willhunt/silvia/docs/docs/README.md

---
home: true
heroImage: /assets/will_silvia_icon.png
tagline: Silviabot smart espresso machine.
actionText: Demo →
actionLink: /demo/
features:
- title: Temperature control
  details: Precise boiler temperature stabilisation using PID control
- title: Remote operation
  details: Machine control via web app, hosted onboard. Turn machine on, create a schedule and view previous sessions.
- title: Brew control
  details: Brew to specified mass, measured using a separate WiFi scale.
footer: Made by William Hunt with VuePress
---
