willhunt/silvia/docs/docs/demo/README.md

# Introduction
## Direct Operation
This video shows demonstration of the machine being used without the web app. Brewing is automatically stopped at the target mass although some additional coffee comes through after the stop is requested (room for improvement). As can be seen the machine is poorly dialled in....just testing at the moment.

<iframe width="560" height="315" src="https://www.youtube.com/embed/h3jJNOzg5Io" frameborder="0" allow="accelerometer; autoplay; clipboard-write; encrypted-media; gyroscope; picture-in-picture" allowfullscreen></iframe>
