willhunt/silvia/docs/docs/control/assets/boiler_boundary_diagram.png

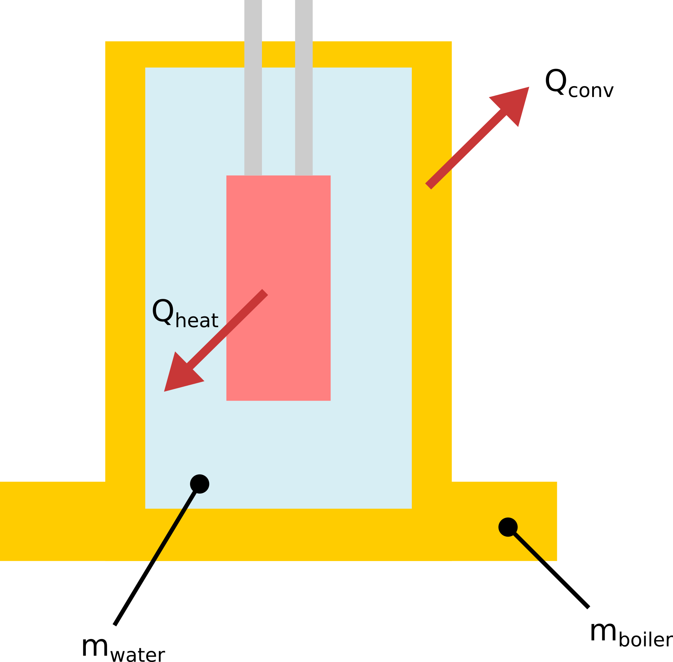
docs/docs/control/assets/boiler_boundary_diagram.png
