willhunt/silvia/docs/docs/.vuepress/public/assets/build/oled_display_panel_facia.stl

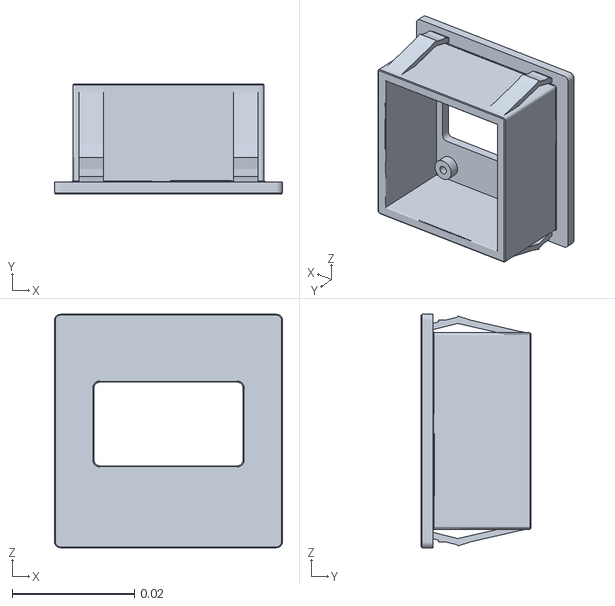
[picture p6: CAD file, 2020-06-29]
docs/docs/.vuepress/public/assets/build/oled_display_panel_facia.stl
0.0373 x 0.018 x 0.0382
