willhunt/silvia/docs/docs/build/power-control.md

---
images_installation: [
    {src: "build_powerrelay_01.jpg", caption: "Installed relay"},
]
images_wiring: [
    {src: "wiring_powercontrol_01.png", caption: "Fritzing wiring diagram for power control"},
]
---

# Power Control
Digital power control was implemented by rewiring the power switch connections to a relay. The switch can be used indirectly to power the machine by wiring to a digital microcontroller pin. The main power switch is a double pole, single throw (DPST) switch, connecting both the live and neutral circuits. To replace this a dual relay was used. The relay used requires 12V to switch so a mosfet is needed to switch from the microcontroller output (5V with Arduino) to a higher 12V circuit. It would have been better to use a relay with a 5V coil voltage but this is what I had available.

## Components
* T92P7D22-12 DPST-NO Relay [[datasheet](https://www.te.com/commerce/DocumentDelivery/DDEController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)]
    * 277V, 30A
    * Dual relay
    * 12V coil voltage
* [12VDC power supply](./power-supply.md)
* IRF520 Mosfet [[datasheet](https://www.vishay.com/docs/91017/91017.pdf)]
    * Gate threshold voltage 4V
    * Drain-source voltage 100V

## Installation

<DocsImageLayout :images="$frontmatter.images_installation" srcBase="/silvia/assets/build/"></DocsImageLayout>

## Wiring
The Arduino switches the mechanical relay with 12V (supplied through barrel jack) with an IRF520 mosfet. A 1k&#8486; pull-down resistor is used to ensure the mosfet input is at 0V when the output in not high. The raspberry pi detects the switch operation via a GPIO pin. This does not require a pull up/down resistor as they are built in.

<DocsImageLayout :images="$frontmatter.images_wiring" size="lg" srcBase="/silvia/assets/build/"></DocsImageLayout>

## Software
### Raspberry pi interrupt
The raspberry pi gpiozero [Button class](https://gpiozero.readthedocs.io/en/stable/api_input.html#gpiozero.Button) is used to detect switch operation which then communicates to the Arduino over I2C via [Celery](https://github.com/celery/celery) asyncrhonus tasks.

```python
from gpiozero import Button

button_power = Button(17)
button_power.when_pressed = trigger_machine_on
button_power.when_released = trigger_machine_off
```

The python interrupt file is registered as a django management command:
```bash
$ python manage.py raspi_interrupt
```

### Arduino relay control
A generic relay control class was used to operate the relays through the standard Arduino interface with the relevant `on()` method being:
```cpp
void RelayOutput::on() {
  status_ = true;
  digitalWrite(pin_, HIGH);
};

```
