willhunt/silvia/docs/docs/setup/arduino-setup.md

# Arduino Setup

The following Arduino libraries are required:

* Wire
* PID
* ~~PID_AutoTune_v0~~
* Adafruit SSD1306
* Adafruit GFX

The arduino can be flashed from the raspberry pi using the script:
```bash
$ cd ~/silvia
$ ./update_arduino.sh
```
