willhunt/silvia/(list of files, drawings)

Other design files:
docs/docs/build/assets/silvia.fzz
docs/docs/build/assets/silvia_brew_control.fzz
docs/docs/build/assets/silvia_oled_display.fzz
docs/docs/build/assets/silvia_power_control.fzz
docs/docs/build/assets/silvia_power_control_old.fzz
docs/docs/build/assets/silvia_scale.fzz
docs/docs/build/assets/silvia_temperature_control.fzz
