willhunt/silvia/silvia_scale/silvia_scale_wifi.h

#ifndef SILVIA_SCALE_WIFI_H
#define SILVIA_SCALE_WIFI_H

#include <ESP8266WiFi.h>
#include <WiFiClient.h>
#include <ESP8266WebServer.h>
#include <ESP8266HTTPClient.h>
#include "wifi_details.h"  // Wifi SSID & password
#include "silvia_scale_display.h"
#include "silvia_scale_timer.h"
#include "silvia_scale_loadcell.h"


ESP8266WebServer* scaleWifiSetup(IPAddress ip, IPAddress subnet, IPAddress gateway, IPAddress dns);
void handleRoot();
void handleGetMass();
void handleTare();
void handleBrewStart();
void handleBrewStop();
void sendBrewStop();

extern double setpoint;
extern double mass;
extern unsigned long t;

#endif  // SILVIA_SCALE_WIFI_H
