willhunt/silvia/silvia/silviacontrol/signals.py

from django.db.models.signals import pre_save, post_delete, post_save
from django.dispatch import receiver
from django.conf import settings as django_settings
from .models import ScheduleModel, ResponseModel, StatusModel, SettingsModel, SessionModel
from .tasks import async_comms_update, async_scale_update
from django_celery_beat.models import CrontabSchedule, PeriodicTask, IntervalSchedule

@receiver(pre_save, sender=ScheduleModel)
def save_schedule(sender, instance, raw, using, update_fields, **kwargs):
    """
    When creating schedule model also create linked django_celery_beat schedule entries
    """
    dow_crontype = ScheduleModel.convert_dow_to_crontype(instance.days)
    # ON SCHEDULE
    if instance.schedule_on is None:
        crontab_on = CrontabSchedule.objects.create(
            minute=instance.t_on.minute,
            hour=instance.t_on.hour,
            day_of_week=dow_crontype,
            day_of_month='*',
            month_of_year='*',
            timezone=django_settings.TIME_ZONE
        )
        schedule_on = PeriodicTask.objects.create(
            crontab=crontab_on,
            name="on:{0} {1}".format(instance.id, instance.name),
            # task='silviacontrol.tasks.async_machine_on',
            task='silviacontrol.tasks.async_comms_update',
            args='[true]',  # json format required
            enabled=instance.active
        )
        instance.schedule_on = schedule_on
    else:
        instance.schedule_on.name = "on:{0} {1}".format(instance.id, instance.name)
        instance.schedule_on.crontab.minute = instance.t_on.minute
        instance.schedule_on.crontab.hour = instance.t_on.hour
        instance.schedule_on.crontab.day_of_week = dow_crontype
        instance.schedule_on.crontab.save()
        instance.schedule_on.enabled = instance.active
        instance.schedule_on.save()
    # OFF SCHEDULE
    if instance.schedule_off is None:
        crontab_off = CrontabSchedule.objects.create(
            minute=instance.t_off.minute,
            hour=instance.t_off.hour,
            day_of_week=dow_crontype,
            day_of_month='*',
            month_of_year='*',
            timezone=django_settings.TIME_ZONE
        )
        schedule_off = PeriodicTask.objects.create(
            crontab=crontab_off,
            name="off:{0} {1}".format(instance.id, instance.name),
            # task='silviacontrol.tasks.async_machine_off',
            task='silviacontrol.tasks.async_comms_update',
            args='[false]',  # json format required
            enabled=instance.active
        )
        instance.schedule_off = schedule_off
    else:
        instance.schedule_off.name = "off:{0} {1}".format(instance.id, instance.name)
        instance.schedule_off.crontab.minute = instance.t_off.minute
        instance.schedule_off.crontab.hour = instance.t_off.hour
        instance.schedule_off.crontab.day_of_week = dow_crontype
        instance.schedule_off.crontab.save()
        instance.schedule_off.enabled = instance.active
        instance.schedule_off.save()


@receiver(post_delete, sender=ScheduleModel)
def delete_schedule(sender, instance, **kwargs):
    """
    When deleting schedule model also delete linked django_celery_beat schedule entries
    """
    try:
        instance.schedule_on.delete()
    except (AssertionError, AttributeError) as e:
        print('No on schedule')
    try:
        instance.schedule_off.delete()
    except (AssertionError, AttributeError) as e:
        print('No off schedule')
    try:
        instance.schedule_on.crontab.delete()
    except (AssertionError, AttributeError) as e:
        print('No Crontab on')
    try:
        instance.schedule_off.crontab.delete()
    except (AssertionError, AttributeError) as e:
        print('No Crontab off')

# @receiver(pre_save, sender=ResponseModel)
# def pre_save_response(sender, instance, raw, using, update_fields, **kwargs):
#     """
#     When creating response model check brewing status and add
#     """
#     status = StatusModel.objects.get(id=1)
#     # Set brewing in response - Now doing this in async_save_response()
#     instance.brewing = status.brew

    # Check if brewing and mass target is reached
    # if status.brew:
    #    settings = SettingsModel.objects.get(id=1)
    #     if instance.m is not None and instance.m >= settings.m:
    #         status.brew = False
    #         status.save()

@receiver(post_save, sender=SettingsModel)
def save_settings(sender, instance, raw, using, update_fields, **kwargs):
    """
    When updating settings model update periodic task and arduino settings
    """
    status = StatusModel.objects.get(pk=1)
    # See if periodic temperature update task exists
    try:
        periodic_response = PeriodicTask.objects.get(name="Get Response")
        #  Update period if different
        if periodic_response.interval.every != instance.t_sample:
            periodic_response.interval.every = instance.t_sample
            periodic_response.interval.save()
    except PeriodicTask.DoesNotExist:
        # Create periodic task if it doesn't exist
        periodic_interval = IntervalSchedule.objects.create(
            every=instance.t_sample,
            period='seconds'
        )
        periodic_response = PeriodicTask.objects.create(
            name="Get Response",
            task="silviacontrol.tasks.async_comms_response",
            enabled=status.on,
            interval=periodic_interval
        )
    # Send to Arduino (update settings, not status, current status values given)
    async_comms_update.delay(status.on, status.brew, status.mode)

@receiver(pre_save, sender=StatusModel)
def save_status(sender, instance, raw, using, update_fields, **kwargs):
    """
    When saving status model turn temperature update on/off
    When saving status model create or end schedule as necessary
    """
    # Account for first creation
    try:
        prior_status = StatusModel.objects.get(pk=1)
    except StatusModel.DoesNotExist as e:
        print("No pre-save processing as no status model found, please create one")
        return False

    # Fill in values not sent
    if not hasattr(instance, "on"):
        instance.on = prior_status.on
    if not hasattr(instance, "brew"):
        instance.brew = prior_status.brew
    if not hasattr(instance, "mode"):
        instance.mode = prior_status.mode

    # Turn on/off periodic response
    try:
        periodic_response = PeriodicTask.objects.get(name="Get Response")
        periodic_response.enabled = instance.on
        periodic_response.save()
    except:
        raise ValueError("Save sample time to create 'Get Response' periodic task")

    # Start/stop sessions
    if instance.on and not prior_status.on:  # Turning machine on
        # Create a new session
        session = SessionModel()
        session.save()
        # If simulating, set temperature to 20degC
        if django_settings.SIMULATE_MACHINE:
            response = ResponseModel.objects.create(
                T_boiler=20,
                duty=0,
                duty_p=0,
                duty_i=0,
                duty_d=0,
                m=0
            )
            response.save()
    elif prior_status.on and not instance.on:  # If machine is being turned off
        # Get current session
        try:
            session = SessionModel.objects.filter(active=True).order_by('-id')[0]
            session.set_end_time()
            session.save()
        except IndexError as e:
            print("No active session")
