willhunt/silvia/silvia_scale/check_circle_outline.h

#define CHECK_CIRCLE_OUTLINE_WIDTH 24
#define CHECK_CIRCLE_OUTLINE_HEIGHT 24
const uint8_t check_circle_outline[] PROGMEM = {
  0x00, 0x00, 0x00, 0x00, 0x00, 0x00, 0x00, 0x7E, 0x00, 0x80, 0xFF, 0x01, 
  0xE0, 0xC1, 0x07, 0x60, 0x00, 0x07, 0x30, 0x00, 0x0C, 0x38, 0x00, 0x1C, 
  0x18, 0x00, 0x3B, 0x0C, 0x80, 0x31, 0x0C, 0xC0, 0x31, 0x0C, 0xF0, 0x30, 
  0xCC, 0x39, 0x30, 0x8C, 0x39, 0x30, 0x1C, 0x1F, 0x38, 0x18, 0x07, 0x18, 
  0x38, 0x02, 0x18, 0x30, 0x00, 0x0C, 0xE0, 0x00, 0x0F, 0xE0, 0x83, 0x07, 
  0x80, 0xFF, 0x01, 0x00, 0x7E, 0x00, 0x00, 0x00, 0x00, 0x00, 0x00, 0x00, 
  };
