willhunt/silvia/silvia_scale/checkbox-marked-circle.h

#define CHECKED_CIRCLE_WIDTH 48
#define CHECKED_CIRCLE_HEIGHT 48
const uint8_t checked_circle[] PROGMEM = {
  0xFF, 0xFF, 0xFF, 0xFF, 0xFF, 0xFF, 0xFF, 0xFF, 0xFF, 0xFF, 0xFF, 0xFF, 
  0xFF, 0xFF, 0xFF, 0xFF, 0xFF, 0xFF, 0xFF, 0xFF, 0xFF, 0xFF, 0xFF, 0xFF, 
  0xFF, 0xFF, 0x01, 0x80, 0xFF, 0xFF, 0xFF, 0x7F, 0x00, 0x00, 0xFE, 0xFF, 
  0xFF, 0x1F, 0x00, 0x00, 0xF8, 0xFF, 0xFF, 0x0F, 0x00, 0x00, 0xF0, 0xFF, 
  0xFF, 0x03, 0x00, 0x00, 0xC0, 0xFF, 0xFF, 0x01, 0x00, 0x00, 0x80, 0xFF, 
  0xFF, 0x00, 0x00, 0x00, 0x00, 0xFF, 0xFF, 0x00, 0x00, 0x00, 0x00, 0xFF, 
  0x7F, 0x00, 0x00, 0x00, 0x00, 0xFE, 0x3F, 0x00, 0x00, 0x00, 0x00, 0xFC, 
  0x3F, 0x00, 0x00, 0x00, 0x08, 0xFC, 0x1F, 0x00, 0x00, 0x00, 0x1C, 0xF8, 
  0x1F, 0x00, 0x00, 0x00, 0x1E, 0xF8, 0x0F, 0x00, 0x00, 0x00, 0x0F, 0xF0, 
  0x0F, 0x00, 0x00, 0x80, 0x07, 0xF0, 0x0F, 0x00, 0x00, 0xC0, 0x03, 0xF0, 
  0x0F, 0x00, 0x00, 0xE0, 0x01, 0xF0, 0x0F, 0x00, 0x00, 0xF0, 0x00, 0xF0, 
  0x0F, 0x10, 0x00, 0x78, 0x00, 0xF0, 0x0F, 0x38, 0x00, 0x3C, 0x00, 0xF0, 
  0x0F, 0x78, 0x00, 0x1E, 0x00, 0xF0, 0x0F, 0xF0, 0x00, 0x0F, 0x00, 0xF0, 
  0x0F, 0xE0, 0x81, 0x07, 0x00, 0xF0, 0x0F, 0xC0, 0xC3, 0x03, 0x00, 0xF0, 
  0x0F, 0x80, 0xE7, 0x01, 0x00, 0xF0, 0x0F, 0x00, 0xFF, 0x00, 0x00, 0xF0, 
  0x0F, 0x00, 0x7E, 0x00, 0x00, 0xF0, 0x1F, 0x00, 0x3C, 0x00, 0x00, 0xF8, 
  0x1F, 0x00, 0x18, 0x00, 0x00, 0xF8, 0x3F, 0x00, 0x00, 0x00, 0x00, 0xFC, 
  0x3F, 0x00, 0x00, 0x00, 0x00, 0xFC, 0x7F, 0x00, 0x00, 0x00, 0x00, 0xFE, 
  0xFF, 0x00, 0x00, 0x00, 0x00, 0xFF, 0xFF, 0x00, 0x00, 0x00, 0x00, 0xFF, 
  0xFF, 0x01, 0x00, 0x00, 0x80, 0xFF, 0xFF, 0x03, 0x00, 0x00, 0xC0, 0xFF, 
  0xFF, 0x0F, 0x00, 0x00, 0xF0, 0xFF, 0xFF, 0x1F, 0x00, 0x00, 0xF8, 0xFF, 
  0xFF, 0x7F, 0x00, 0x00, 0xFE, 0xFF, 0xFF, 0xFF, 0x01, 0x80, 0xFF, 0xFF, 
  0xFF, 0xFF, 0xFF, 0xFF, 0xFF, 0xFF, 0xFF, 0xFF, 0xFF, 0xFF, 0xFF, 0xFF, 
  0xFF, 0xFF, 0xFF, 0xFF, 0xFF, 0xFF, 0xFF, 0xFF, 0xFF, 0xFF, 0xFF, 0xFF, 
  };
