willhunt/silvia/(commit log)

2020-05-20 Basic frontend framework in place
2020-05-22 Changed on/off to switch
2020-05-22 Added temperature update
2020-05-26 Prototype ready for testing on hardware
2020-05-31 Format temperature
2020-05-31 Simulated aysnc temperature update
2020-06-03 Basic arduino sketch roughed out
2020-06-04 I2C test
2020-06-06 Script to detect button press
2020-06-06 Added GPIO for raspberry pi
2020-06-06 Pin number fix
2020-06-10 Move relay control to arduino as IRF520 needs 5V to sitch
2020-06-15 Arduino i2c
    [silvia.fzz]
2020-06-17 Pin uddate
2020-06-18 Added input switch
    [silvia.fzz]
2020-06-18 Added carriage returns
2020-06-18 Trying to get i2c to work
2020-06-19 Changed to redis and celery_once for temperature task
2020-06-19 Add setpoint to i2c
2020-06-19 Changed to printf
2020-06-19 Make changes to brew control. Now working for power
2020-06-23 Arduino code for screen now compiles
2020-06-24 RST pin update
2020-06-25 Removing unused software serial call sfixed i2cdetect problem on pi
    [silvia_output.cpp, silvia_output.h]
2020-06-25 See if this is the problem
    [tasks.py]
2020-06-25 See if thiss is the problem
    [display.py]
2020-06-25 Try to avoid I/O error
    [tasks.py]
2020-06-25 Change to circuit python library
2020-06-29 Vuepress docs added
    [oled_display_panel_facia.stl, silvia.fzz, silvia_brew_control.fzz, silvia_oled_display.fzz, silvia_power_control.fzz, silvia_power_supply.fzz, silvia_temperature_control.fzz]
2020-08-10 revert to old version
    [display_cp.py, tasks.py]
2020-08-10 Update to using board
2020-08-10 Revert as seperate task queue doesn't ensure delay
    [display_cp.py, tasks.py]
2020-08-11 Changed to serial arduino comms
2020-08-11 Reformat to allow i2c or serial to Arduino
2020-08-12 fixed update microcontroller calls
    [tasks.py]
2020-08-12 Try no temp display as not working agaian obver i2c
    [tasks.py]
2020-08-12 back to i2c
2020-08-12 Maybe this was causing problems
    [raspi_interrupt.py]
2020-08-13 try i2c
2020-08-17 PID fixes
2020-08-20 Added heater off
2020-08-20 Arduino cli added to pi
2020-08-20 Until new sensor added
2020-08-24 MIght need to have PID on
2020-08-24 Need relay control in tuning loop
2020-08-24 PID changes
2020-08-27 postgres implemented plus fixes
    [signals.py, views.py]
2020-09-01 switch value
2020-09-02 move display to arduino
2020-09-03 Arduino display
2020-09-04 sprintf does not work with floating point numbers on arduino
    [silvia_display.cpp]
2020-09-04 Fix temperature sensor
2020-09-06 debug sensor
2020-09-06 Add arduino
2020-09-06 initialise pid output
2020-09-07 doc update
    [silvia_brew_control.fzz, silvia_oled_display.fzz, silvia_power_control.fzz, silvia_power_control_old.fzz, silvia_power_supply.fzz, silvia_temperature_control.fzz]
2020-09-08 fix scehdule strat time on frontend
    [signals.py]
2020-09-10 increase sensor update frequency
2020-09-10 Try P_ON_M pid
2020-09-11 Increase filtering
2020-09-14 Add P on M to PID
2020-09-18 Try setting output to 0 on pid reset
    [silvia_pi_comms.cpp, silvia_temperature_controller.cpp]
2020-09-20 Moving average filter
2020-10-07 Change to arduino control with buttons, frontend more responsive
2020-10-08 Send Arduino settings on boot
2020-10-08 FLipped arduino switch logic to reflect pull-up
    [silvia_arduino.ino]
2020-10-08 Fix change mode with on/off
    [silvia_arduino.ino, silvia_function.cpp, silvia_function.h]
2020-10-09 Arduino switch code fix
    [silvia_arduino.ino, silvia_output.cpp, silvia_output.h]
2020-10-21 STarting to add pressure control. Not finished
